adoreblvnk/whattheflip/reports/tribunal-1/SE06_PreTri1.md

# Week 8 Tribunal 1: SE06 Pre-Tribunal Architecture Defence

Group: SE06 (Lab P1) | Repo: https://github.com/adoreblvnk/whattheflip | Target: ESP32-C6 RISC-V @ 160 MHz + Dual RP2040 Picos | OS: uT-Kernel 3.0

## Executive Summary & Document Governance

This document represents Deliverable 1 (`SE06_PreTri1`). We prepared our architecture defence across 3 versions:
* **Version A (Pre-Tribunal AI Ideation):** Fully populated. Contains our pre-tribunal technical preparation across 5 buddies using frontier AI models (Sonnet 5.5, GLM 5.3, and GLM 5.3 Flash). We vetted every recommendation against physical ESP32-C6 hardware constraints and the uT-Kernel 3.0 runtime.
* **Version B (Live Zoom-Updated Version):** Formatted with complete scaffolding. Serves as our live working notebook during the 90-min recorded breakout session (11:15 AM to 12:45 PM), capturing live challenges, counter-defences, and immediate adaptations to the unannounced requirement change.
* **Version C (Final AI-Vetted Gap Check):** Formatted with scaffolding and reflection prompts, scheduled for post-tribunal execution and submission by Oct 23, 23:59 hrs.

## 1. Team Information & Subsystem Ownership

| Item | Details |
|---|---|
| **Group ID** | **SE06 (Lab P1)** |
| **Repository Link** | `https://github.com/adoreblvnk/whattheflip` (Target: ESP32-C6 RISC-V @ 160 MHz, uT-Kernel 3.0) |

### 1.1 Buddy Roster & Technical Responsibilities

| Buddy | Student Name & ID | Primary Subsystem / Persona & Technical Responsibility |
|---|---|---|
| **Buddy 1** | **Tan Yan Qi**<br>*Student Entry* | **Wired Protocol Auto-Discovery Engine:** 4-pin hardware edge timing via RMT RX, pulse histogram profiling, baud estimation (9600 to 115200 baud +- 2%, I2C 100/400 kHz +- 2%), and dynamic probe-to-protocol pin mapping (GP4-GP7). |
| **Buddy 2** | **Annie Goh**<br>*Student Entry* | **Physical Chaos & Fault Injection Engine:** Hardware Event Task Matrix (ETM) / RMT TX pulse glitching (< 500ns jitter), single-bit in-flight flips, I2C ACK to NACK suppression, and 220 ohm series protection clamping. |
| **Buddy 3** | **Zayne Lee**<br>*Student Entry* | **Wireless Multi-Protocol Sniffer:** Promiscuous 2.4 GHz raw radio capture (Wi-Fi 6 / 802.11ax Ch 1-13 management/beacon frames and IEEE 802.15.4 Zigbee Ch 11-26), isolated deauthentication containment. |
| **Buddy 4** | **Ryan Ke**<br>*Student Entry* | **Telemetry Ingestion & PCAP Storage Engine:** Zero-copy fixed memory pool (`MPF_PACKETS`, 32 KB), standard `libpcap` binary packet serialization, FAT32 MicroSD SPI block logging, and Wireshark export. |
| **Buddy 5** | **Joseph Poon**<br>*Student Entry* | **System Supervisor, Safety Lockout & Web UI:** uT-Kernel 3.0 task coordination, hardware GPIO E-Stop direct register override (<= 200ns to High-Z), local Wi-Fi SoftAP WebSocket telemetry server (Ch 6). |

### 1.2 3-Node File Hierarchy & Low-Level Design (LLD) Function Map

We structured our codebase across 3 dedicated hardware nodes following Barr C standard:

```
whattheflip/
├── node1_esp32c6_tool/                # Node 1: Diagnostic Tool & Fuzzer (uT-Kernel 3.0)
│   ├── include/
│   │   ├── auto_discovery.h           # RMT RX edge sampling & baud clustering prototypes
│   │   ├── chaos_fuzzer.h             # ETM / RMT TX glitch injection prototypes
│   │   ├── wireless_sniffer.h         # Wi-Fi 6 & 802.15.4 promiscuous capture prototypes
│   │   ├── pcap_storage.h             # libpcap formatting & SD sector flush prototypes
│   │   ├── supervisor_safety.h        # E-Stop ISR & WebSocket telemetry prototypes
│   │   └── system_config.h            # Pinout definitions (GP4-GP7), pool sizes, baud bounds
│   └── src/
│       ├── auto_discovery.c           # probe_sample_edges_rmt(), classify_baud_histogram()
│       ├── chaos_fuzzer.c             # fuzzer_arm_trigger(), fuzzer_inject_glitch_etm()
│       ├── wireless_sniffer.c         # wifi_promiscuous_rx_cb(), zigbee_frame_parse()
│       ├── pcap_storage.c             # pcap_write_global_hdr(), pcap_write_frame(), sd_flush_sector()
│       ├── supervisor_safety.c        # safety_estop_isr(), ws_broadcast_telemetry()
│       └── main.c                     # inittask(), task creation (tk_cre_tsk), pool init (tk_cre_mpf)
├── node2_pico_wired_victims/          # Node 2: Dual RP2040 Breadboard Testbed (Pico C SDK)
│   ├── victim_a_master/
│   │   ├── main.c                     # pico_a_uart_tx_burst(), pico_a_i2c_master_poll()
│   │   └── gy511_driver.c             # lsm303dlhc_read_accel(), lsm303dlhc_read_mag()
│   └── victim_b_slave/
│       └── main.c                     # pico_b_uart_rx_verify(), pico_b_i2c_slave_handler()
└── node3_esp32c6_wireless_victim/     # Node 3: Wireless Over-the-Air Target (ESP-IDF)
    └── main/
        ├── victim_ap.c                # start_victim_softap(), broadcast_target_beacon()
        └── victim_zigbee.c            # start_802154_tx(), send_raw_zigbee_frame()
```

| Hardware Node & File | LLD Function Name | Owner & RTOS Task | Purpose & Execution Context |
|---|---|---|---|
| **Node 1 (ESP32-C6)**<br>`src/auto_discovery.c` | `probe_sample_edges_rmt()` | **Tan**<br>`AutoDiscovery_Task` (P4) | Streams pulse duration items via RMT RX DMA into internal ring buffers; 0 CPU interrupt overhead. |
| **Node 1 (ESP32-C6)**<br>`src/auto_discovery.c` | `classify_baud_histogram()` | **Tan**<br>`AutoDiscovery_Task` (P4) | Runs statistical clustering on edge times; locks protocol within <= 500ms; emits `FLG_PROTO_LOCKED`. |
| **Node 1 (ESP32-C6)**<br>`src/chaos_fuzzer.c` | `fuzzer_arm_trigger()` | **Annie**<br>`Chaos_Fuzzer_Task` (P3) | Acquires `MTX_PROBE_ACCESS`, arms hardware ETM comparator, and configures pulse width (<= 10us). |
| **Node 1 (ESP32-C6)**<br>`src/chaos_fuzzer.c` | `fuzzer_inject_glitch_etm()` | **Annie**<br>Hardware ETM / RMT TX | Hardware-timed bit-flip or I2C ACK suppression; delivers pulse with < 500ns jitter through 220 ohm resistor. |
| **Node 1 (ESP32-C6)**<br>`src/wireless_sniffer.c`| `wifi_promiscuous_rx_cb()` | **Zayne**<br>Radio Baseband ISR | Executes in < 5us; acquires buffer from `MPF_PACKETS` via `tk_tget_mpf(..., TMO_POL)`; drops frame if full. |
| **Node 1 (ESP32-C6)**<br>`src/wireless_sniffer.c`| `zigbee_frame_parse()` | **Zayne**<br>`Wireless_Engine_Task` (P2) | Drains raw IEEE 802.15.4 frame queue, validates FCS checksum, and pushes to storage buffer. |
| **Node 1 (ESP32-C6)**<br>`src/pcap_storage.c` | `pcap_write_frame()` | **Ryan**<br>`Storage_Task` (P5) | Serializes packets into binary `libpcap` format (16-byte header + payload) and releases pool buffer via `tk_rel_mpf`. |
| **Node 1 (ESP32-C6)**<br>`src/pcap_storage.c` | `sd_flush_sector()` | **Ryan**<br>`Storage_Task` (P5) | Flushes 512-byte aligned sectors to MicroSD SPI card; decoupled via `MBF_STORAGE` (depth 16). |
| **Node 1 (ESP32-C6)**<br>`src/supervisor_safety.c`| `safety_estop_isr()` | **Joseph**<br>GPIO9 Hardware ISR | Direct register write to `GPIO.enable_w1tc` in < 200ns to float probes to High-Z; sets `FLG_SAFETY_ABORT`. |
| **Node 1 (ESP32-C6)**<br>`src/supervisor_safety.c`| `ws_broadcast_telemetry()` | **Joseph**<br>`Web_Dashboard_Task` (P6) | Packages bus statistics into JSON and transmits 1 to 2 Hz WebSocket frames over local Wi-Fi SoftAP (Ch 6). |
| **Node 2 (Pico A)**<br>`victim_a/main.c` | `pico_a_uart_tx_burst()` | Target Breadboard Victim A | Transmits known periodic UART frames (115200 baud) to Victim B for sniffing and fuzzing stimulus. |
| **Node 2 (Pico B)**<br>`victim_b/main.c` | `pico_b_uart_rx_verify()` | Target Breadboard Victim B | Receives UART stream, logs framing error counts and CRC mismatches to USB CDC serial console. |

## 2. Version A: Pre-Tribunal AI Ideation

* **AI Model Evaluation Mandate:** We queried 3 frontier models (Sonnet 5.5, GLM 5.3, and GLM 5.3 Flash) to stress-test subsystem designs against physical ESP32-C6 hardware limits.
* **Evaluation Standard:** We filtered AI suggestions through strict criteria: 0 dynamic heap allocation (`malloc`/`free`), interrupt overhead, sub-microsecond timing accuracy, bus contention, and pin strapping stability.

### 2.1 Pre-Tribunal AI Ideation Matrix

| Subsystem Lead  | AI Model & Prompt Used | Useful AI Ideas | Weak / Unrealistic AI Ideas | Position Before Zoom |
| --- | --- | --- | --- | --- |
| **Tan Yan Qi**  | **Model:** Sonnet 5.5<br><br>**Prompt:** *"I am designing the Wired Protocol Auto-Discovery Engine on ESP32-C6 under uT-Kernel 3.0 across 4 GPIO probe pins (GP4-GP7). We need to identify UART (9600-115200 baud) and I2C (100/400 kHz) within 500 ms without manual probing. What RTOS architecture and hardware peripheral strategy should I use?"* | * Suggested using hardware edge timing (ESP32-C6 RMT RX peripheral) with DMA ring buffers to offload edge capture from CPU.<br>* Proposed statistical pulse width histogramming to cluster baud rates deterministically.<br>* Emphasized keeping probe pins in High-Z floating mode during boot. | * Suggested attaching a software GPIO interrupt ISR (`gpio_isr_handler_add`) to every pin edge and enqueueing timestamps into a message queue (`tk_snd_mbx`).<br>* At 400 kHz I2C, 800,000 edge interrupts/sec would completely overwhelm the 160 MHz RISC-V CPU, causing 100% CPU lockup.<br>* Hallucinated a non-existent ESP32-C6 hardware I2C auto-baud register. | **Reject software GPIO edge ISRs. Commit to hardware RMT RX peripheral offload.** RMT RX captures pulse durations directly into internal RAM without CPU involvement; `AutoDiscovery_Task` (Priority 4) periodically polls and classifies pulse distributions using statistical bounds (eg 8.68us +- 2% for 115200 baud; 2.5us +- 2% for 400 kHz I2C). |
| **Annie Goh** | **Model:** GLM 5.3<br><br>**Prompt:** *"How can I implement deterministic physical bit-flip fault injection and I2C ACK suppression on an ESP32-C6 running uT-Kernel 3.0 with sub-500 ns jitter, while ensuring that driving the target line low does not burn the target microcontrollers (Raspberry Pi Pico)?"* | * Highlighted that RTOS task scheduling jitter (1 to 5us) makes software-timed GPIO toggles unusable for single-bit glitching at 115200 baud (8.68us bit width).<br>* Recommended hardware Event Task Matrix (ETM) tied to RMT/timers for sub-microsecond pulse delivery.<br>* Emphasized open-drain emulation for I2C and hardware clamping. | * Suggested using a bidirectional level shifter (TXS0108E) as an active glitch injector, which introduces 10 to 15ns edge distortion and fails on fast open-drain rise times.<br>* Suggested driving push-pull high directly against victim UART TX, which creates a dead short (> 40mA) and risks silicon degradation. | **Eliminate external level shifter; use direct 3.3V bus coupling with a mandatory 220 ohm inline series resistor on breadboard row GP0 (Victim A TX).** For I2C, strictly enforce open-drain mode (`GPIO_MODE_OUTPUT_OD`) so our tool only pulls LOW and floats HIGH. Pre-acquire `MTX_PROBE_ACCESS` in `Chaos_Fuzzer_Task` (Priority 3) before arming, and trigger pulses via hardware ETM / RMT TX (< 500ns jitter, pulse <= 10us, duty cycle <= 5%). |
| **Zayne Lee** | **Model:** Sonnet 5.5<br><br>**Prompt:** *"On an ESP32-C6 with uT-Kernel 3.0, we need to capture 802.11ax Wi-Fi management frames and IEEE 802.15.4 Zigbee frames simultaneously while hosting a local Web UI for telemetry. What are the RF architecture risks and how should we configure the promiscuous callback?"* | * Confirmed that ESP32-C6 shares a single 2.4 GHz RF front-end between Wi-Fi and 802.15.4, meaning true simultaneous physical capture is impossible.<br>* Recommended a deterministic time-multiplexed capture window.<br>* Warned against executing blocking calls inside the promiscuous callback. | * Claimed ESP32-C6 can do simultaneous full-duplex dual-protocol capture using internal virtual MACs.<br>* Suggested using standard FreeRTOS queues directly inside the ESP-IDF promiscuous callback to pass packets to uT-Kernel, which causes kernel context corruption because ESP-IDF Wi-Fi callbacks run in private ISR context.<br>* Suggested capturing raw BLE link-layer packets without hardware baseband support. | **Formalize RF time-multiplexing: run SoftAP Web UI on Channel 6, and time-slice sniffing windows onto target channels (Wi-Fi Ch 1-13 or 802.15.4 Ch 11-26).** Restrict promiscuous callback to non-blocking memory pool acquisition (`tk_tget_mpf` with `TMO_POL`) from `MPF_PACKETS`; if pool is full, increment drop counter and drop packet immediately rather than stalling radio ISR. Confine deauth frames strictly to Node 3 isolated BSSID (`02:00:00:00:00:03`). |
| **Ryan Ke** | **Model:** GLM 5.3 Flash<br><br>**Prompt:** *"Design a zero-copy telemetry ingestion and MicroSD logging pipeline on ESP32-C6 under uT-Kernel 3.0. The system must buffer wireless bursts and continuous 500 kbps wired streams without dynamic malloc, writing standard libpcap format to a FAT32 MicroSD card. Calculate buffer sizes and determine task priority."* | * Derived that raw 802.11 MTU frames are up to 1514+ bytes (with headers up to 2048 bytes), requiring buffer blocks larger than generic 256-byte sensor buffers.<br>* Recommended pre-allocated Fixed Memory Pools (`tk_cre_mpf`) and 512-byte aligned writes to optimize SPI SD sector flushing. | * Recommended an 8 KB buffer pool with 256-byte blocks, which would instantly truncate or corrupt 802.11 management beacons and Wi-Fi packets.<br>* Suggested writing each packet to MicroSD as JSON text (`fprintf`), which would add severe string formatting overhead and block the SPI bus for > 50ms per write, causing catastrophic packet loss. | **Upsize `MPF_PACKETS` to 32 KB (16 fixed blocks of 2048 B), guaranteeing 0 packet truncation for standard MTU frames.** Serialize packets into binary `libpcap` format (24-byte global header, 16-byte packet header + payload) to enable native Wireshark inspection. Set `Storage_Task` (`TSK_STORAGE`) priority to Low (Priority 5) and decouple it via message queue `MBF_STORAGE` (depth 16) so slow MicroSD SPI sector write latencies (<= 40ms) never stall bus acquisition. |
| **Joseph Poon** | **Model:** GLM 5.3<br><br>**Prompt:** *"How should the System Supervisor task on ESP32-C6 coordinate emergency stop (E-Stop), a local Wi-Fi WebSocket dashboard, and peripheral status indicators under uT-Kernel 3.0, ensuring NFR-1 (E-Stop response <= 5 ms) and zero dynamic memory allocation?"* | * Recommended handling E-Stop as an edge-triggered hardware GPIO interrupt directly manipulating GPIO output-enable registers (`GPIO.enable_w1tc`) to float probe pins in < 200ns, completely bypassing RTOS scheduling latency.<br>* Recommended static buffer allocation for WebSocket frame encoder. | * Suggested including an onboard 0.96 OLED display alongside the WebSocket dashboard. An OLED consumes 1 KB RAM, bus bandwidth, and introduces display-refresh blocking delays (> 20ms) that interfere with supervisor responsiveness.<br>* Suggested routing E-Stop through a normal RTOS message queue to be processed by a worker task, violating the <= 5ms safety preemption requirement. | **Drop the OLED display; rely entirely on the WebSocket dashboard over Wi-Fi and onboard NeoPixel/buzzer.** Implement E-Stop as a 2-stage mechanism: Stage 1 (Hardware ISR) directly clears `GPIO.enable_w1tc` in < 200ns to float all 4 probe channels to High-Z, then sets event flag `FLG_SAFETY_ABORT`; Stage 2 (`Safety_Supervisor_Task`, Priority 1) wakes, commands WS2812 status LED to RED, activates buzzer (`EXIO3`), and coordinates systematic task disarm within 2ms (<= 5ms bound). Ensure GPIO9 boot strapping pin is unpressed during power-up. |

### 2.2 Week 6 Architecture Defence Snapshot Before Zoom

| Week 6 Artefact / Claim | What We Claimed in Week 6 | Evidence Available Now Defending It | Still Weak or Untested | Defending Lead |
|---|---|---|---|---|
| **Hardware Integration:**<br>Direct 3.3V Bus Coupling<br>(NFR-4) | We eliminated TXS0108E bidirectional level shifter; coupled ESP32-C6 probes directly to RP2040 3.3V rails (3.3V +- 5%, V_abs <= 3.63V) with 220 ohm series resistor on Victim A TX line. | Voltage compliance verified against RP2040 datasheet (V_IO = 3.3V) and ESP32-C6 TRM; removing shifter eliminates 10ns propagation delay and open-drain rise-time distortion. 220 ohm resistor bounds push-pull short circuit current to <= 15mA. | Transient capacitive ringing during high-speed switching (> 1 MHz) across breadboard jumper wires not yet verified on high-bandwidth oscilloscope. | **Annie Goh** |
| **Memory Management:**<br>Deterministic Fixed Pool<br>(NFR-2 / NFR-3) | 0 dynamic heap allocations (`malloc`/`free`) during continuous capture and fault injection; all telemetry and packet serialization uses pre-allocated 32 KB Fixed Memory Pool `MPF_PACKETS` (16 blocks of 2048 B). | Week 6 memory map allocates `MPF_PACKETS` in BSS segment; diagnostic benchmark (`test1_chip_diagnostics.ino`) confirms 512 KB SRAM headroom with > 250 KB free heap remaining. | Sustained 10-min continuous stress test at 500 kbps to verify 0 pool exhaustion when MicroSD sector write latency spikes to 40ms. | **Ryan Ke** |
| **Fault Injection Precision:**<br>Sub-Microsecond Glitch Timing<br>(NFR-5) | Fault injection pulses synchronize to target bus trigger edges with timing jitter < 500ns, completely bypassing RTOS task scheduling jitter. | Hardware Event Task Matrix (ETM) connects GPIO comparator directly to RMT TX channel; hardware trigger path operates within 3 to 5 clock cycles (< 50ns at 160 MHz). | Jitter under heavy radio DMA traffic (concurrent Wi-Fi promiscuous RX) not yet empirically measured on physical digital storage oscilloscope. | **Annie Goh** |
| **Safety Architecture:**<br>E-Stop Hardware Preemption <= 5ms<br>(NFR-1) | Emergency stop on GP12 (`GPIO9` BOOT switch) preempts all background processing, floating all 4 probe channels to High-Z within < 200ns (ISR) and completing system-wide alarm and task disarm within <= 5ms. | Stage 1 ISR directly writes to 32-bit register `GPIO.enable_w1tc`, taking < 50ns; `Safety_Supervisor_Task` runs at highest system priority (Priority 1). | Verifying that pressing E-Stop during power-on reset does not hold GPIO9 low and accidentally force ESP32-C6 into ROM UART bootloader mode. | **Joseph Poon** |
| **Bus Auto-Discovery:**<br>Hardware RMT RX Offload<br>(FR-1 / FR-2) | Passive auto-discovery accurately identifies UART (9600-115200 baud, +- 2%) and I2C (100/400 kHz, +- 2%) within <= 500ms across 4 pins without CPU interrupt thrashing. | ESP32-C6 RMT peripheral has 4 RX channels capable of streaming pulse duration items directly to RAM via DMA without per-edge CPU interrupts. | Accuracy of statistical baud clustering in the presence of bus noise, reflections, or flat-line idle states during bus reset. | **Tan Yan Qi** |
| **Wireless Architecture:**<br>Time-Multiplexed 2.4 GHz RF Front-End<br>(FR-4 / Assumption A4) | The single 2.4 GHz RF transceiver operates in distinct, time-multiplexed capture modes (Wi-Fi 6 promiscuous Ch 1-13 vs IEEE 802.15.4 Zigbee Ch 11-26), while the Web UI dashboard runs on Home Channel 6. | ESP32-C6 RF architecture documentation confirms shared baseband; firmware state machine implements dedicated `WIFI_SNIFF` and `ZIGBEE_SNIFF` states. | Packet loss rate of WebSocket telemetry updates during channel-hopping sweeps across distant Wi-Fi channels (eg Ch 1 or Ch 13). | **Zayne Lee** |

### 2.3 Shared Resource Allocation Matrix

| Shared Resource | Used by Task(s) | Owner Task / Module | Access Type | Contention Risk | Mitigation | Evidence Needed |
| --- | --- | --- | --- | --- | --- | --- |
| **Probe GPIO Bus**<br>(GP4-GP7 / GPIO6, 7, 14, 15) | `AutoDiscovery_Task`, `Chaos_Fuzzer_Task`, `Safety_Supervisor_Task` | `AutoDiscovery_Task` (Default), `Chaos_Fuzzer_Task` (Armed) | Time-exclusive; High-Z read default; Transient low drive during glitch  | Fuzzer drives pin while Auto-Discovery is measuring edge timing, corrupting baud estimation or creating bus contention. | Protected by uT-Kernel mutex `MTX_PROBE_ACCESS`. Fuzzer must acquire mutex before arming. E-Stop ISR overrides via direct register write. | DSO capture showing probe pins cleanly release to High-Z before fuzzer arming; 0 mutex deadlocks over 100 contention cycles. |
| **Onboard MicroSD Card SPI Bus**<br>(GPIO10, 11, 12, 15 / Pins 14-16, 20) | `Storage_Task` exclusively; inputs fed from `Wireless_Engine` & `AutoDiscovery` | `Storage_Task` (`TSK_STORAGE`) | Dedicated master SPI bus; block sector writes (512 B) | Slow SD card flash write latency spikes (<= 40ms) block high-speed packet ingestion tasks. | Decoupled by message buffer `MBF_STORAGE` (depth 16) and zero-copy fixed memory pool `MPF_PACKETS`. Producer tasks enqueue pointers; `Storage_Task` drains at Priority 5. | Benchmark showing 0 dropped packets during simulated 40ms SD card flash block-erase stall. |
| **2.4 GHz RF Transceiver Baseband** | `Wireless_Engine_Task`, `Web_Dashboard_Task` | `Wireless_Engine_Task` (`TSK_WIRELESS`) | Time-multiplexed RF front-end (RX promiscuous vs TX SoftAP beacon/data) | SoftAP telemetry broadcasts on Channel 6 interrupted or dropped when radio hops to Channel 1 or Zigbee Channel 15 to capture packets. | Time-sliced buffering: sniffer captures on target channel for 1 to 2s into memory pool, then returns to Channel 6 to flush telemetry over WebSocket. | RF channel dwell timer logs showing clean return to Channel 6 without WebSocket client disconnection. |
| **Fixed Packet Memory Pool**<br>(`MPF_PACKETS`, 32 KB / 16 Blocks of 2048 B) | `Wireless_Engine_Task`, `AutoDiscovery_Task`, `Storage_Task`, `Web_Dashboard` | Kernel Object (`MPF_PACKETS`), allocated at system boot | Zero-copy pointer exchange across task message queues | Memory pool exhaustion during burst traffic leads to task deadlock or packet dropping. | Non-blocking acquisition `tk_tget_mpf(..., TMO_POL)`. If pool exhausted, drop packet and increment drop counter; never block radio ISR. Consumers release via `tk_rel_mpf`. | Stress test verifying pool block count never leaks over 10,000 allocate/release cycles. |
| **Onboard I2C Expansion Bus**<br>(TCA9554PWR on GPIO22/GPIO23) | `Safety_Supervisor_Task` exclusively | `Safety_Supervisor_Task` (`TSK_SAFETY`) | Master I2C write to control Piezo Buzzer (`EXIO3`) and status LEDs | I2C bus hang or arbitration loss if another task attempts to probe expander pins while safety buzzer is being commanded. | Strictly isolate TCA9554PWR I2C bus to `Safety_Supervisor_Task`. Baseboard pushbuttons 1 & 2 (GP20/GP21) are strictly banned from software use to prevent shorting expander I2C lines to ground. | I2C bus analyzer log confirming 0 unauthorized transactions on address `0x20` (TCA9554). |

### 2.4 Subsystem Interface and Code Structure Map

| Module / File / Interface | Provider | Consumer(s) | Purpose | Inputs | Outputs | Interface Rule | Validation Rule |
| --- | --- | --- | --- | --- | --- | --- | --- |
| `auto_discovery.c`<br>`probe_sample_edges_rmt()` | **Tan** | `AutoDiscovery_Task`, `Chaos_Fuzzer_Task`, `Web_Dashboard_Task` | Samples edge transition timestamps from 4 probe channels via RMT RX, computes pulse statistics, and resolves active bus pinout. | RMT RX DMA raw buffer (pulse item stream, microsecond timestamps) | `proto_desc_t` (Protocol: UART/I2C/IDLE, Baud rate, Pin roles: TX, RX, SDA, SCL) | Only `AutoDiscovery_Task` executes baud classification; emits event flag `FLG_PROTO_LOCKED` upon stable identification (>= 95% confidence over 500ms). | Pass if UART (9600-115200 baud, +- 2%) and I2C (100/400 kHz, +- 2%) correctly identified within <= 500ms on test bench. |
| `chaos_fuzzer.c`<br>`fuzzer_invert_uart_bit()`<br>`fuzzer_ack_suppress_i2c()` | **Annie** | `Chaos_Fuzzer_Task`, Target Victims (Pico A & Pico B) | Injects deterministic, single-bit pulse glitches (< 500ns jitter) or pulls I2C SDA low during 9th clock cycle to force NACK. | Fuzz target trigger pattern, delay offset, pulse duration (<= 10us, duty cycle <= 5%) | Timed GPIO pulse on probe line via hardware ETM / RMT TX channel | Must acquire `MTX_PROBE_ACCESS` before configuring ETM trigger; immediately float pin to High-Z upon completion or E-Stop event flag. | Oscilloscope capture showing edge-to-pulse jitter < 500ns, current draw <= 15mA through 220 ohm resistor, and victim reporting framing error/NACK. |
| `wireless_sniffer.c`<br>`wifi_promiscuous_rx_cb()`<br>`zigbee_rx_cb()` | **Zayne** | `Wireless_Engine_Task`, `Storage_Task`, `Web_Dashboard_Task` | Captures raw over-the-air 802.11ax and 802.15.4 packets, filters headers, extracts RSSI, and passes packets to storage buffer. | Raw radio baseband FIFO interrupts and frame buffers | Serialized packet buffer pushed to `MBF_STORAGE` and `MBF_TELEMETRY` | Promiscuous callback must execute in < 5us; acquires buffer via `tk_tget_mpf(..., TMO_POL)`; drops frame if pool is full; never blocks. | Serial log confirming <= 0.1% frame drop rate during 100 pkt/s beacon burst; Wireshark validates captured PCAP checksums. |
| `pcap_storage.c`<br>`pcap_write_frame()`<br>`sd_flush_sector()` | **Ryan** | `Storage_Task`, MicroSD SPI Driver | Formats captured packets with 16-byte `libpcap` header, stages data into 512-byte sector cache, and flushes to FAT32 MicroSD card. | Packet descriptor from `MBF_STORAGE`, microsecond timestamp, length, raw bytes | 512-byte block SPI commands to MicroSD card (`/sdcard/capture.pcap`) | All writes are sector-aligned; 0 dynamic allocations; releases packet buffer back to `MPF_PACKETS` via `tk_rel_mpf` immediately after sector staging. | MicroSD card mounted on PC opens in Wireshark with 0 corrupted headers or malformed length fields. |
| `supervisor_safety.c`<br>`safety_estop_isr()`<br>`ws_broadcast_telemetry()` | **Joseph** | `Safety_Supervisor_Task`, All system tasks, Web UI clients | Coordinates system health monitoring, executes hardware E-Stop probe disarm, and streams live 1 to 2 Hz JSON telemetry over WebSocket. | GPIO9 switch interrupt, system task health flags, telemetry queue `MBF_TELEMETRY` | `GPIO.enable_w1tc` 32-bit register clear, WS2812 LED color, buzzer output, WebSocket JSON frames over Wi-Fi | Stage 1 E-Stop executes directly in ISR without RTOS scheduling; WebSocket transmission drops telemetry frames if client socket buffer is congested. | Oscilloscope confirms probe pin floats to High-Z within < 200ns of E-Stop press; dashboard displays live packet rate at 1 to 2 Hz +- 10%. |

### 2.5 Week 6 Assumption Closure

| Assumption ID | Original Assumption Statement | Current Status | Evidence Collected | Remaining Risk | Next Action & Owner |
| --- | --- | --- | --- | --- | --- |
| **A0**<br>(Vendor Coexistence) | uT-Kernel 3.0 and ESP-IDF closed-source binary drivers (Wi-Fi/802.15.4 blobs) can coexist via the FreeRTOS translation shim without memory corruption. | **Needs Validation**<br>*(Hurdle for Week 8)* | FreeRTOS translation shim in `esp32c6-mtk3` compiles; standalone benchmark test (`test1_chip_diagnostics.ino`) validates basic RTOS boot. | Vendor Wi-Fi blob may invoke un-shimmed FreeRTOS primitives at runtime, causing silent memory corruption or kernel panic. | Flash test firmware with promiscuous RX enabled; verify 30-min run without panic before Week 8 demo.<br>**Owner:** Zayne |
| **A1**<br>(Direct 3.3V Driving) | ESP32-C6 GPIO pins can switch from High-Z Input to Driven Output in < 1us for targeted bit glitching without damaging target microcontrollers. | **Validated / Closed** | Integrated 220 ohm series resistor limits short-circuit current to <= 15mA; pulse duration clamped to <= 10us (<= 5% duty cycle); open-drain mode used on I2C. | Minor capacitive rise time degradation on breadboard wiring (~15ns). | Probe edge slew rate on physical DSO during Week 8 lab session.<br>**Owner:** Annie |
| **A2**<br>(Buffer Overrun Risk) | ESP32-C6 promiscuous packet filter captures raw 802.11 management frames without dropping frames at burst rates up to 50 to 100 pkts/s. | **Validated / Closed** | Fixed memory pool `MPF_PACKETS` upsized from 8 KB to 32 KB (16 blocks of 2048 B), absorbing burst traffic even when MicroSD write stalls for 40ms. | Flash write latency exceeding 100ms on degraded/unbranded SD cards. | Mandate SanDisk Extreme Class 10 U3 MicroSD card; measure sector write latency distribution.<br>**Owner:** Ryan |
| **A3**<br>(Deauth Containment) | Targeted deauth injection will be contained strictly to isolated testbed victim node without spilling into campus Wi-Fi. | **Validated / Closed** | Hardware BSSID/MAC allow-list (`02:00:00:00:00:03`) hardcoded in firmware; broadcast deauth (`FF:FF:FF:FF:FF:FF`) strictly prohibited in software state machine. | User accidentally modifying target MAC address in web dashboard. | Enforce firmware validation check that rejects any MAC outside the testbed namespace.<br>**Owner:** Zayne |
| **A4**<br>(Single RF Multiplexing) | Single 2.4 GHz RF front-end can switch between Wi-Fi and Zigbee without crashing the SoftAP telemetry server. | **Converted to Risk / Mitigated** | Time-sliced capture architecture documented in Section 2; dashboard operates on Channel 6, sniffer sweeps remote channels and buffers data locally before returning to Channel 6. | WebSocket client may experience momentary 1-second packet delivery latency during channel hop. | Implement client-side WebSocket heartbeat reconnection handling in HTML5 dashboard.<br>**Owner:** Joseph |
| **A5**<br>(Auto-Discovery Accuracy) | Passive 4-pin auto-discovery edge timing can classify UART and I2C within 500ms without false locks. | **Open / In Progress** | RMT RX DMA driver implemented; timing threshold tables defined (8.68us +- 2% for 115200 baud; 2.5us +- 2% for 400 kHz I2C). | High bus noise or floating pins could trigger spurious edge transitions before protocol lock. | Integrate 3-stage debounce filter and require at least 16 valid consecutive edge rhythms before emitting `FLG_PROTO_LOCKED`.<br>**Owner:** Tan |
| **A6**<br>(E-Stop & GPIO9 Invariant) | Hardware E-Stop button on GPIO9 can preempt all tasks within 5ms while maintaining boot stability. | **Validated / Closed** | ISR writes to `GPIO.enable_w1tc` in < 200ns; operational invariant established requiring GPIO9 to remain unpressed during the first 50ms power-on reset. | User accidentally holding E-Stop during board power-up, causing ESP32-C6 to enter ROM download mode. | Add power-on warning LED pattern in bootloader and document requirement in physical testbed setup guide.<br>**Owner:** Joseph |
| **A7**<br>(GPIO15 JTAG Strapping) | PROBE_3 on GPIO15 (Maker Pi GP7) can be used as a probe without interfering with JTAG debug or board reset. | **Validated / Closed** | GPIO15 is kept in High-Z floating mode during boot; verified ESP32-C6 boot log via UART0 console shows normal flash boot into application. | Victim pulling line LOW during reset could divert JTAG lines. | Connect I2C SCL to GP7 only after boot confirmation or use internal pull-up.<br>**Owner:** Tan |

## 3. Version B: Live Zoom-Updated Version (Live Tribunal Session)

> **LIVE SESSION WORKING NOTEBOOK (OCTOBER 19, 11:15 TO 12:45)**  
> This section records our live technical challenges, counter-defences, decision changes, and system adaptations in response to **Change Requirement 3: Port to µT-Kernel 3 SMP** issued by Prof. Muhamed Fauzi Bin Abbas.

### 3.1 Buddy Contributions During Zoom
| Team Member | Technical Challenge Raised | Teammate Counter-Challenge / Defence | Engineering Trade-Off / Compromise Reached | Affected Artefact / File |
|---|---|---|---|---|
| **Tan Yan Qi**<br>(Auto-Discovery) | Evaluated porting Node 1 auto-discovery to µT-Kernel 3 SMP, proposing a secondary core task to process RMT edge buffers, per Sonnet 5.5 output. | Joseph proved the ESP32-C6 is single-core silicon (`PORT_ESP32C6.md` line 128: *"makes no attempt at SMP"*). Ryan added that RMT RX offloads edge timing to DMA at 0% CPU, making multi-core processing redundant. | Retained Node 1 on single-core µT-Kernel 3.0 (`esp32c6-mtk3`). Redirected the µT-Kernel 3 SMP port (`mtk3smp-rp2040`) to Node 2 (Dual RP2040 Victims), assigning Core 0 to UART Master and Core 1 to I2C Master. | `node1_esp32c6_tool/src/auto_discovery.c`<br>`node2_pico_wired_victims/victim_a_master/main.c` |
| **Annie Goh**<br>(Chaos Fuzzer) | Investigated moving hardware fuzzer trigger loops to Core 1 of an SMP processor to execute parallel glitch injection. | Joseph cited `PORT_RP2040.md` showing the recursive Big Kernel Lock (BKL) has a worst-case hold time of 85µs and masks local interrupts, which would introduce tens of microseconds of jitter into glitch pulses. | Kept fuzzer on Node 1 ESP32-C6 where hardware Event Task Matrix (ETM) and RMT TX trigger glitch pulses in < 50ns, completely bypassing RTOS scheduling and SMP lock contention. | `node1_esp32c6_tool/src/chaos_fuzzer.c`<br>`fuzzer_inject_glitch_etm()` |
| **Zayne Lee**<br>(Wireless Sniffer) | Evaluated migrating Node 3 (Wireless Victim) to a Raspberry Pi Pico W running `mtk3smp-rp2040` (`SMP=1 WIFI=cyw43`) to satisfy the SMP requirement on wireless. | Joseph and Annie proved that the Pico W's CYW43439 radio is Wi-Fi 4 (802.11b/g/n) only and has 0% IEEE 802.15.4 silicon, making Zigbee transmission physically impossible; SoftAP beaconing is also unported. | Retained Node 3 on ESP32-C6 under ESP-IDF to preserve native Wi-Fi 6 + 802.15.4 frame generation. Defended this as an unalterable physical radio hardware constraint. | `node3_esp32c6_wireless_victim/main/victim_ap.c`<br>`node3_esp32c6_wireless_victim/main/victim_zigbee.c` |
| **Ryan Ke**<br>(PCAP Storage) | Explored offloading `Storage_Task` to Core 1 under SMP to decouple MicroSD SPI sector writes from packet capture. | Tan noted that `PORT_RP2040.md` lists inherited peripheral drivers as single-owner and includes zero FAT32 / SD card drivers in its qualified release; an SMP SD driver would require writing a custom locking layer. | Retained `Storage_Task` on Node 1 ESP32-C6 at Priority 5, using `SPI2_HOST` with `MBF_STORAGE` (depth 16) and `MPF_PACKETS` (32 KB fixed pool), absorbing 40ms SD write stalls without SMP lock overhead. | `node1_esp32c6_tool/src/pcap_storage.c`<br>`sd_flush_sector()` |
| **Joseph Poon**<br>(Supervisor & Safety) | Audited Change Requirement 3's mandate ("Port to µT-Kernel 3 SMP") and identified a fatal safety conflict: the 85µs BKL interrupt-mask window destroys the < 200ns E-Stop requirement. | Team unanimously agreed: forcing Node 1 to RP2040 SMP degrades safety response by 425x. Furthermore, the RP2040 SMP port provides no qualified SoftAP or WebSocket stack for the telemetry dashboard. | Adopted the definitive architectural cutover: Port Node 2 (Dual RP2040 Victims) to `mtk3smp-rp2040` (`SMP=1`), assigning Core 0 (`TP_PRC1`) to UART and Core 1 (`TP_PRC2`) to I2C via `TA_ASSPRC`. Node 1 and Node 3 remain single-core. | `node1_esp32c6_tool/src/supervisor_safety.c`<br>`node2_pico_wired_victims/app_main.c` |

### 3.2 Live Decision Change Log
| Decision ID | Item / Topic | Decision (Changed vs Kept) | Engineering Reason & Evidence | Owner / Subsystem |
|---|---|---|---|---|
| **D-01** | Node 2 Wired Victims OS Architecture | **CHANGED** | Ported Node 2 Dual RP2040 Victims from bare-metal Pico SDK to µT-Kernel 3 SMP (`mtk3smp-rp2040`, `SMP=1`). Core 0 runs `Victim_A_UART_Task`; Core 1 runs `Victim_B_I2C_Task`. Fulfills CR3 mandate. | Tan / Auto-Discovery |
| **D-02** | Node 2 SMP Task-to-Core Affinity | **CHANGED** | Configured static processor affinity using `TA_ASSPRC`: `Victim_A_Task` assigned to Processor 1 (`TP_PRC1` / Core 0); `Victim_B_Task` assigned to Processor 2 (`TP_PRC2` / Core 1). Synchronized via `MBF_VICTIM_SYNC`. | Annie / Chaos Fuzzer |
| **D-03** | Node 1 Diagnostic Tool OS Architecture | **KEPT (CONFIRMED)** | Retained Node 1 on single-core µT-Kernel 3.0 (`esp32c6-mtk3`). Proved ESP32-C6 silicon is single-core (`PORT_ESP32C6.md` line 128); prevents 85µs BKL interrupt masking from violating the < 200ns E-Stop preemption limit. | Joseph / Safety Supervisor |
| **D-04** | Node 3 Wireless Victim Platform | **KEPT (CONFIRMED)** | Retained Node 3 on ESP32-C6 under ESP-IDF. Raspberry Pi Pico W's CYW43439 lacks IEEE 802.15.4 (Zigbee) radio hardware, lacks Wi-Fi 6, and provides no qualified SoftAP beacon generator in `mtk3smp-rp2040`. | Zayne / Wireless Sniffer |
| **D-05** | Zero Dynamic Heap Invariant | **KEPT (CONFIRMED)** | Rejected AI recommendation for dynamic SMP task queues; retained 32 KB Fixed Memory Pool `MPF_PACKETS` (16 blocks of 2048 B) and statically allocated task stacks across both Node 1 and Node 2. | Ryan / PCAP Storage |
| **D-06** | Hardware E-Stop Direct Register Override | **KEPT (CONFIRMED)** | Stage 1 ISR direct write to `GPIO.enable_w1tc` in < 200ns on GPIO9 BOOT switch retained without kernel lock interference. Stage 2 supervisor task preemption completes in <= 5ms. | Joseph / Safety Supervisor |

### 3.3 Resource and Assumption Review
| Item Challenged | Evidence Presented | Decision Made | Impact on Other Buddies |
|---|---|---|---|
| **Silicon Core Architecture (ESP32-C6 vs RP2040)** | `PORT_ESP32C6.md` line 128 states C6 port is single-core only. `PORT_RP2040.md` lines 3-6 confirms RP2040 is the ONLY SMP port in the course family. | Prohibit running SMP on Node 1 (ESP32-C6). Target the µT-Kernel 3 SMP port strictly to Node 2 (RP2040). | All buddies keep their Node 1 firmware structure; Tan and Annie write SMP tasks for Node 2. |
| **Big Kernel Lock (BKL) Interrupt Masking** | `PORT_RP2040.md` records 85µs maximum BKL hold time and notes *"BKL masks local interrupts while held."* | Keep E-Stop ISR decoupled from BKL; Stage 1 register write must never wait on SMP spinlocks. | Joseph guarantees < 200ns probe isolation; fuzzer disarm remains 100% deterministic. |
| **2.4 GHz RF Front-End Capabilities** | Pico W CYW43439 datasheet: Wi-Fi 4 only, 0% 802.15.4 silicon. `PORT_RP2040.md`: CYW43439 is a development profile without SoftAP. | Reject migrating Node 3 to Pico W. Keep Node 3 on ESP32-C6 to generate real 802.11ax and 802.15.4 frames. | Zayne captures valid multi-protocol wireless frames; Joseph's dashboard remains on Home Ch 6. |
| **RP2040 I2C Peripheral Driver Scope** | `mtk3smp-rp2040/device/i2c/sysdepend/rp2040/i2c_rp2040.c` hardcodes `I2C_CON_SLAVE_DISABLE | I2C_CON_MASTER_MODE`. | On Node 2, configure Core 1 Victim B as an I2C Master reading a second sensor, or patch driver for slave mode. | Eliminates driver lockup on Node 2 breadboard testbed. |
| **32 KB Fixed Memory Pool (`MPF_PACKETS`)** | Memory audit confirms 16 blocks of 2048 B absorb 40ms MicroSD flash write stalls at 500 kbps wired streaming. | Retain 32 KB fixed pool size; zero heap allocation during active monitoring and fault injection. | Ryan guarantees zero buffer overflow; memory pool watermark logged to telemetry. |

### 3.4 Integration Risk Register
| Risk ID | Risk Description | Cause | Impact | Likelihood | Severity | Mitigation | Owner & Status |
|---|---|---|---|---|---|---|---|
| **R1** | BKL contention on Node 2 causes timing jitter in victim UART/I2C stimulus generation. | Both cores on RP2040 serialize through single recursive Big Kernel Lock (85µs hold). | Cross-core message handoff delays and irregular victim transmission intervals. | Med | Med | Decouple victim tasks using lockless circular ring buffers (`smp_atomic.c`) outside the BKL. | Tan / Open |
| **R2** | RP2040 stock I2C driver in `mtk3smp` is master-only, preventing standard I2C slave response. | Driver hardcodes `I2C_CON_SLAVE_DISABLE`; slave mode unported in official release. | Victim B cannot acknowledge I2C read requests from Victim A. | High | High | Reconfigure Victim B on Core 1 as a second I2C master polling on separate address, or patch `i2c_rp2040.c`. | Annie / Open |
| **R3** | Breadboard signal ringing between dual RP2040 fast GPIO edges and ESP32-C6 probe inputs. | Fast Cortex-M0+ switching slew rates across 15 cm solderless breadboard jumper wires. | False edge triggers or degraded baud rate classification on Auto-Discovery. | Med | Med | Maintain inline 220 ohm series protection resistors and enable RMT RX 3-cycle digital debounce filter. | Tan / Open |

### 3.5 Cross-Subsystem Test Plan
| Test ID | Subsystem / Workload | Test Case Description | Objective Success Criteria | Evidence Required | Owner & Status |
|---|---|---|---|---|---|
| **TC-INT-1** | SMP Multi-Core Task Affinity | Execute `Victim_A_UART_Task` on Core 0 (`TP_PRC1`) and `Victim_B_I2C_Task` on Core 1 (`TP_PRC2`) concurrently. | Processor IDs reported via `tk_get_prc()` strictly match 1 and 2; zero cross-core task migration. | USB-CDC serial console log showing concurrent dual-core execution banner. | Tan / Open |
| **TC-INT-2** | Emergency Stop Preemption under SMP | Trigger E-Stop while Node 2 RP2040 is actively transmitting dual-core UART + I2C burst traffic. | Probe pins float to High-Z in < 200ns; system disarms in <= 5ms; zero bus contention current. | DSO capture showing probe line floating within < 200ns of GPIO9 edge + serial log. | Joseph / Open |
| **TC-INT-3** | Cross-Core IPC & BKL Soak Test | Stream 10,000 cross-core synchronization tokens between Core 0 and Core 1 via `MBF_VICTIM_SYNC`. | 100% token integrity; 0 dropped messages; maximum BKL wait <= 36µs; zero kernel lockups over 10-min soak. | Test log showing 10,000/10,000 matched tokens with zero API errors. | Annie / Open |
| **TC-INT-4** | Multi-Protocol Capture against SMP Testbed | ESP32-C6 captures concurrent Node 2 SMP wired traffic (115200 baud) and Node 3 wireless beacons. | PCAP file written to MicroSD contains valid interleaved UART packets and Wi-Fi beacons; drop rate <= 0.1%. | PCAP file opened in Wireshark with zero corrupted headers or malformed frames. | Ryan / Open |

### 3.6 Constraint Injection / Curveball Response
* **Injected Requirement Change (Verbatim):** *The system firmware must be ported from its current RTOS to µT-Kernel 3 SMP, using the course µT-Kernel 3 SMP port. All existing application functionality must operate under µT-Kernel 3 SMP. The previous RTOS must not remain responsible for any application task, scheduling, inter-task communication or synchronisation. As this is an SMP implementation, teams must define and justify the task-to-core assignment. Data and resources shared between tasks or cores must be protected appropriately, and ISRs must interact safely with µT-Kernel tasks.*

| Team Member | Immediate Impact on Subsystem | Specific Firmware / Hardware Adaptation | Trade-Off / Unaffected Rationale |
|---|---|---|---|
| **Tan Yan Qi** | Evaluated auto-discovery multi-core offload. Found ESP32-C6 is single-core; RP2040 is the only SMP hardware. | Ported Node 2 Wired Victims to `mtk3smp-rp2040` (`SMP=1`); implemented `Victim_A_UART_Task` pinned to Core 0 (`TP_PRC1`). | Auto-discovery on Node 1 remains on single-core µT-Kernel 3.0; hardware RMT RX DMA already achieves 0% CPU. |
| **Annie Goh** | Evaluated moving fuzzer to an SMP core; found 85µs BKL interrupt mask destroys < 500ns glitch jitter. | Implemented `Victim_B_I2C_Task` on Node 2 Core 1 (`TP_PRC2`) via `TA_ASSPRC` to provide dual-core victim stimulus. | Fuzzer on Node 1 remains on single-core ESP32-C6 ETM hardware to guarantee < 50ns trigger jitter. |
| **Zayne Lee** | Investigated migrating Node 3 to Pico W SMP; found CYW43439 lacks 802.15.4 Zigbee radio hardware. | Kept Node 3 on ESP32-C6 under ESP-IDF to preserve native Wi-Fi 6 + Zigbee frame transmission. | Pico W CYW43439 is Wi-Fi 4 only and unported for SoftAP beaconing; keeping C6 is a physical necessity. |
| **Ryan Ke** | Evaluated moving storage to SMP; found RP2040 SMP port lacks qualified FAT32 / SD card drivers. | Retained `Storage_Task` on Node 1 ESP32-C6 at Priority 5, flushed via dedicated `SPI2_HOST` controller. | Storage remains fully decoupled via 32 KB `MPF_PACKETS` pool; avoids writing an unqualified SMP SD driver. |
| **Joseph Poon** | Audited E-Stop and Web UI under SMP; found BKL masks interrupts for 85µs (violating < 200ns E-Stop) and CYW43439 lacks WebSockets. | Preserved Stage 1 direct register write `GPIO.enable_w1tc` (< 200ns) on Node 1. Authored Node 2 dual-core SMP task allocation. | Defended why Node 1 must remain single-core to preserve hard real-time safety and WebSocket telemetry. |

### 3.7 Integration Readiness Self-Assessment
| Readiness Area | Status | Evidence Supporting Assessment | Remaining Concern |
|---|---|---|---|
| **Hardware wiring known** | **Green** | Probe pin mapping frozen on GP4-GP7 (GPIO6, 7, 14, 15); inline 220 ohm protection resistor and unified GND plane verified on breadboard. | Breadboard jumper parasitic capacitance on high-speed switching lines. |
| **RTOS task ownership clear** | **Green** | Node 1: 6 tasks with defined priorities (P1 Safety to P6 Dashboard). Node 2: 2 SMP tasks statically pinned via `TA_ASSPRC` (`TP_PRC1` and `TP_PRC2`). | BKL contention latency on Node 2 cross-core message buffer exchanges. |
| **Shared resources identified** | **Green** | Node 1: `MTX_PROBE_ACCESS` guards probes; `SPI2_HOST` owns MicroSD; `MPF_PACKETS` manages memory. Node 2: RP2040 hardware spinlocks serialize SMP kernel. | Long MicroSD card sector erase latency spikes (> 40ms) under cheap flash media. |
| **Critical statecharts implementable** | **Green** | All 6 subsystem statecharts (System, Auto-Discovery, Fuzzer, Wireless, Storage, Safety) fully integrated with nominal and exception arcs. | Timeout calibration for baud classification rhythm verification under noisy buses. |
| **Safety or fault handling defined** | **Green** | Two-stage E-Stop: Stage 1 hardware ISR (< 200ns) directly writes `GPIO.enable_w1tc`, completely immune to RTOS and BKL scheduling delays; Stage 2 supervisor disarms <= 5ms. | Operational invariant: GPIO9 must remain unpressed during power-on reset. |
| **Week 10 partial integration feasible** | **Green** | Dual-core SMP kernel builds cleanly (`make SMP=1` passes Phase 12 58/58 gate); standalone benchmark validates C6 boot and memory pool allocation. | Soak-testing cross-core token exchange between Victim A and Victim B under continuous fuzzing. |

**Updated readiness position before the Week 10 partial integration demo:**  
Our system architecture has successfully adapted to Change Requirement 3 by deploying the course $\mu\text{T-Kernel}$ 3 SMP port (`mtk3smp-rp2040`, `SMP=1`) on the Node 2 Dual RP2040 Wired Victims. By assigning Core 0 (`TP_PRC1`) to `Victim_A_UART_Task` and Core 1 (`TP_PRC2`) to `Victim_B_I2C_Task` via static affinity (`TA_ASSPRC`), our testbed provides authentic multi-core SMP workload generation with cross-core synchronization while strictly adhering to physical hardware limits. Crucially, Node 1 remains on single-core $\mu\text{T-Kernel}$ 3.0 (`esp32c6-mtk3`), preserving our $< 200\text{ ns}$ direct register E-Stop safety guarantee (`GPIO.enable_w1tc`) free from Big Kernel Lock interrupt masking, and maintaining our dual-protocol 2.4 GHz promiscuous sniffing capabilities. All cross-subsystem contracts remain decoupled through pre-allocated fixed memory pools and message queues, ensuring total integration readiness for Week 10.
## 4. Version C: Final AI-Vetted Gap Check (Scaffolding for Post-Zoom)

> **POST-TRIBUNAL GAP CHECK PROTOCOL (DUE OCTOBER 23, 23:59)**  
> We will execute this section post-Zoom. We will submit the complete Version B discussion transcript and updated decisions to an AI reviewer prompted as a strict embedded systems evaluator. All identified gaps will be logged, triaged (Fix, Reject, Defer), and justified with engineering evidence.

* **AI Reviewer Prompt Used:** *[To be inserted post-Zoom. Format: "Act as a strict embedded systems reviewer for whattheflip. Review the updated Version B decisions, resource allocations, and cross-subsystem test plans..."]*

### 4.1 Post-Discussion AI Gap Analysis
| AI-Identified Gap | Team Response (Fix / Reject / Defer) | Action Taken | Engineering Evidence / Reason |
|---|---|---|---|
| *[Gap 1]* | *[To be filled post-Zoom by Oct 23]* | *[To be filled post-Zoom]* | *[To be filled post-Zoom]* |
| *[Gap 2]* | *[To be filled post-Zoom by Oct 23]* | *[To be filled post-Zoom]* | *[To be filled post-Zoom]* |
| *[Gap 3]* | *[To be filled post-Zoom by Oct 23]* | *[To be filled post-Zoom]* | *[To be filled post-Zoom]* |
| *[Gap 4]* | *[To be filled post-Zoom by Oct 23]* | *[To be filled post-Zoom]* | *[To be filled post-Zoom]* |
| *[Gap 5]* | *[To be filled post-Zoom by Oct 23]* | *[To be filled post-Zoom]* | *[To be filled post-Zoom]* |

### 4.2 Final Tribunal Summary
| Final Reflection Question | Team Answer & Synthesis |
|---|---|
| **What is the strongest part of the current design?** | *[To be synthesized post-Zoom by Oct 23]* |
| **What is most likely to fail?** | *[To be synthesized post-Zoom by Oct 23]* |
| **What evidence supports readiness?** | *[To be synthesized post-Zoom by Oct 23]* |
| **What did AI miss that human discussion revealed?** | *[To be synthesized post-Zoom by Oct 23]* |
| **What did AI correctly identify after discussion?** | *[To be synthesized post-Zoom by Oct 23]* |
