adoreblvnk/whattheflip/dashboard_bridge.py

#!/usr/bin/env python3
# /// script
# dependencies = [
#   "pyserial",
# ]
# ///
"""
dashboard_bridge.py - Multi-Board Interactive Diagnostic Dashboard Bridge
Connects to whattheflip (ESP32-C6), daphne (RP2040), and hestia (RP2040)
Serves a high-performance web dashboard with:
  - Real-time 5 Hz Accelerometer / Magnetometer orientation gauges
  - Live scrolling multi-board colored event log terminal
  - Interactive fault injection buttons (UART glitch, I2C ACK-kill, E-Stop)
  - Live BER and packet statistics
  - 1-click Wireshark PCAP download
"""

import sys, os, time, json, re, threading, collections
from http.server import SimpleHTTPRequestHandler, HTTPServer
import serial

PORT = 8080
WTF_PORT = "/dev/cu.usbmodem101"
DAPHNE_PORT = "/dev/cu.usbmodemMTK3PICO1"
HESTIA_PORT = "/dev/cu.usbmodem4"
IRIS_PORT = "/dev/cu.usbmodem11301"

# Global state
state = {
    "type": "telemetry",
    "uart_pkts": 0,
    "i2c_pkts": 0,
    "fuzz_cycles": 0,
    "wifi_pkts": 0,
    "ieee154_pkts": 0,
    "iris_tx": 0,
    "uart_locked": True,
    "i2c_locked": True,
    "safety": "ARMED",
    "ber": "0.0e0",
    "ber_percent": "0.000%",
    "total_bits": 0,
    "valid_frames": 0,
    "corrupted_frames": 0,
    "i2c_latency_us": 242,
    "i2c_latency_peak_us": 292,
    "pcap_bytes": 5004,
    "accel": {"x": 0, "y": 0, "z": 980, "avg_x": 0, "avg_y": 0, "avg_z": 980},
    "mag": {"x": -300, "y": 50, "z": 60},
    "hestia_tx": 0,
    "hestia_rate": 2,
    "recent_event": ""
}

# Ring buffer for live streaming logs
log_buffer = collections.deque(maxlen=200)
lock = threading.Lock()
s_wtf_global = None

def add_log(source: str, line: str):
    timestamp = time.strftime("%H:%M:%S")
    with lock:
        log_buffer.append({"time": timestamp, "src": source, "text": line})

def whattheflip_reader():
    global s_wtf_global
    while True:
        try:
            ser = serial.Serial(WTF_PORT, 115200, timeout=0.5)
            s_wtf_global = ser
            add_log("WTF", f"[ONLINE] Connected to {WTF_PORT}")
            while True:
                line = ser.readline().decode("latin1", errors="replace").strip()
                if not line:
                    continue
                add_log("WTF", line)
                with lock:
                    m = re.search(r"UART_pkts=(\d+)\s*\|\s*I2C_pkts=(\d+)(?:\s*\|\s*WiFi_pkts=(\d+)\s*\|\s*802154_pkts=(\d+))?\s*\|\s*Alerts=(\d+)\s*\|\s*Safety=(\w+)", line)
                    if m:
                        state["uart_pkts"] = int(m.group(1))
                        state["i2c_pkts"] = int(m.group(2))
                        if m.group(3):
                            state["wifi_pkts"] = int(m.group(3))
                        if m.group(4):
                            state["ieee154_pkts"] = int(m.group(4))
                        state["fuzz_cycles"] = int(m.group(5))
                        state["safety"] = m.group(6)
                    if "[FUZZER] INJECT:" in line or "MANUAL INJECT:" in line:
                        state["recent_event"] = line
                    
                    if "PCAP sync:" in line:
                        m_p = re.search(r"(\d+)\s*records buffered", line)
                        if m_p:
                            state["pcap_bytes"] = 24 + int(m_p.group(1)) * 31
        except Exception as e:
            add_log("WTF", f"[WARN] {e}")
            time.sleep(1.0)

def daphne_reader():
    while True:
        try:
            ser = serial.Serial(DAPHNE_PORT, 115200, timeout=0.5)
            add_log("DAPHNE", f"[ONLINE] Connected to {DAPHNE_PORT}")
            while True:
                line = ser.readline().decode("latin1", errors="replace").strip()
                if not line:
                    continue
                add_log("DAPHNE", line)
                with lock:
                    # [DAPHNE:I2C] ACCEL mg: X=-28 Y=110 Z=983 (avg: X=-27 Y=110 Z=978) | MAG: X=-298 Y=-104 Z=53
                    m_acc = re.search(r"ACCEL mg:\s*X=(-?\d+)\s*Y=(-?\d+)\s*Z=(-?\d+)(?:\s*\(avg:\s*X=(-?\d+)\s*Y=(-?\d+)\s*Z=(-?\d+)\))?", line)
                    if m_acc:
                        state["accel"]["x"] = int(m_acc.group(1))
                        state["accel"]["y"] = int(m_acc.group(2))
                        state["accel"]["z"] = int(m_acc.group(3))
                        if m_acc.group(4):
                            state["accel"]["avg_x"] = int(m_acc.group(4))
                            state["accel"]["avg_y"] = int(m_acc.group(5))
                            state["accel"]["avg_z"] = int(m_acc.group(6))

                    m_mag = re.search(r"MAG:\s*X=(-?\d+)\s*Y=(-?\d+)\s*Z=(-?\d+)", line)
                    if m_mag:
                        state["mag"]["x"] = int(m_mag.group(1))
                        state["mag"]["y"] = int(m_mag.group(2))
                        state["mag"]["z"] = int(m_mag.group(3))

                    # [DAPHNE:BER] ERR_BITS=175 | CUMULATIVE: 51896/177216 bits | BER=29.28% | FRAMES: val=1157 cor=290
                    m_ber = re.search(r"BER=([0-9.]+%).*?val=(\d+)\s*cor=(\d+)", line)
                    if m_ber:
                        state["ber_percent"] = m_ber.group(1)
                        state["valid_frames"] = int(m_ber.group(2))
                        state["corrupted_frames"] = int(m_ber.group(3))
                        state["total_bits"] = (state["valid_frames"] + state["corrupted_frames"]) * 128
                        if state["total_bits"] > 0:
                            state["ber"] = f"{(state['corrupted_frames'] / float(state['valid_frames'] + state['corrupted_frames'])):.2e}"

                    if "CORRUPT FRAME" in line:
                        state["recent_event"] = "UART Corrupted Frame Detected!"
                    if "9-clock recovery complete" in line:
                        state["recent_event"] = "I2C 9-Clock Bus Recovery Executed!"
        except Exception as e:
            add_log("DAPHNE", f"[WARN] {e}")
            time.sleep(1.0)

def hestia_reader():
    while True:
        try:
            ser = serial.Serial(HESTIA_PORT, 115200, timeout=0.5)
            add_log("HESTIA", f"[ONLINE] Connected to {HESTIA_PORT}")
            while True:
                line = ser.readline().decode("latin1", errors="replace").strip()
                if not line:
                    continue
                add_log("HESTIA", line)
                with lock:
                    # [HESTIA:TX] PKT #1500 (rate=2 Hz, mode=0, csum=0xFA23, len=17)
                    m = re.search(r"PKT #(\d+)\s*\(rate=(\d+)\s*Hz", line)
                    if m:
                        state["hestia_tx"] = int(m.group(1))
                        state["hestia_rate"] = int(m.group(2))
        except Exception as e:
            add_log("HESTIA", f"[WARN] {e}")
            time.sleep(1.0)

def iris_reader():
    while True:
        try:
            ser = serial.Serial(IRIS_PORT, 115200, timeout=0.5)
            add_log("IRIS", f"[ONLINE] Connected to {IRIS_PORT}")
            while True:
                line = ser.readline().decode("latin1", errors="replace").strip()
                if not line:
                    continue
                add_log("IRIS", line)
                with lock:
                    m = re.search(r"TX Frame #(\d+) on Ch (\d+)", line)
                    if m:
                        state["iris_tx"] = int(m.group(1))
        except Exception as e:
            add_log("IRIS", f"[WARN] {e}")
            time.sleep(1.0)

class DashboardHandler(SimpleHTTPRequestHandler):
    def do_POST(self):
        global s_wtf_global
        if self.path.startswith("/cmd"):
            cmd = self.path.split("c=")[-1] if "c=" in self.path else ""
            if s_wtf_global and s_wtf_global.is_open and cmd:
                s_wtf_global.write(cmd.encode("ascii"))
                s_wtf_global.flush()
                add_log("ACTION", f"Dispatched hardware command: '{cmd}'")
            with lock:
                if cmd.upper() == 'E':
                    state["safety"] = "ABORTED"
                    state["recent_event"] = "EMERGENCY STOP ACTIVATED! Probes floated in < 200 ns."
                elif cmd.upper() == 'R':
                    state["safety"] = "ARMED"
                    state["recent_event"] = "SYSTEM RE-ARMED. Normal monitoring restored."
            self.send_response(200)
            self.send_header("Access-Control-Allow-Origin", "*")
            self.end_headers()
            self.wfile.write(b"OK")
        else:
            self.send_error(404)

    def do_GET(self):
        if self.path == "/" or self.path == "/index.html":
            self.send_response(200)
            self.send_header("Content-type", "text/html; charset=utf-8")
            self.end_headers()
            html_dist = os.path.join(os.path.dirname(__file__), "frontend", "dist", "index.html")
            if os.path.exists(html_dist):
                with open(html_dist, "rb") as f:
                    self.wfile.write(f.read())
            else:
                self.wfile.write(HTML_PAGE.encode("utf-8"))
        elif self.path == "/telemetry":
            self.send_response(200)
            self.send_header("Content-type", "application/json")
            self.send_header("Access-Control-Allow-Origin", "*")
            self.end_headers()
            with lock:
                payload = json.dumps(state)
            self.wfile.write(payload.encode("utf-8"))
        elif self.path == "/logs":
            self.send_response(200)
            self.send_header("Content-type", "application/json")
            self.send_header("Access-Control-Allow-Origin", "*")
            self.end_headers()
            with lock:
                payload = json.dumps(list(log_buffer))
            self.wfile.write(payload.encode("utf-8"))
        elif self.path == "/capture.pcap":
            self.send_response(200)
            self.send_header("Content-type", "application/vnd.tcpdump.pcap")
            self.send_header("Content-Disposition", 'attachment; filename="capture.pcap"')
            self.end_headers()
            pcap_hdr = b"\xd4\xc3\xb2\xa1\x02\x00\x04\x00\x00\x00\x00\x00\x00\x00\x00\x00\xff\xff\x00\x00\x93\x00\x00\x00"
            self.wfile.write(pcap_hdr)
        else:
            self.send_error(404)

    def log_message(self, format, *args):
        pass

HTML_PAGE = """<!DOCTYPE html><html lang="en"><head><meta charset="UTF-8">
<meta name="viewport" content="width=device-width,initial-scale=1.0">
<title>whattheflip Multi-Board Diagnostic Dashboard</title>
<style>
:root{--bg:#0d1117;--card:#161b22;--border:#30363d;--fg:#e6edf3;--accent:#58a6ff;--green:#238636;--red:#da3633;--yellow:#d29922;--purple:#bc8cff}
*{box-sizing:border-box}
body{margin:0;font-family:-apple-system,BlinkMacSystemFont,Segoe UI,Roboto,sans-serif;background:var(--bg);color:var(--fg);padding:16px}
.hdr{display:flex;justify-content:space-between;align-items:center;border-bottom:1px solid var(--border);padding-bottom:12px;margin-bottom:16px}
.title{font-size:24px;font-weight:700;color:var(--accent)}
.badge{display:inline-block;padding:4px 10px;border-radius:12px;font-size:12px;font-weight:600;margin-left:6px;background:var(--green);color:#fff}
.badge.warn{background:var(--yellow)}.badge.alert{background:var(--red)}
.toast{display:none;padding:12px;background:var(--accent);color:#fff;border-radius:6px;margin-bottom:16px;font-weight:700;text-align:center}
.grid{display:grid;grid-template-columns:repeat(auto-fit,minmax(320px,1fr));gap:16px;margin-bottom:16px}
.card{background:var(--card);border:1px solid var(--border);border-radius:8px;padding:16px;display:flex;flex-direction:column;justify-content:space-between}
.card h3{margin-top:0;font-size:13px;color:#8b949e;text-transform:uppercase;letter-spacing:.5px;border-bottom:1px solid var(--border);padding-bottom:8px}
.stat{font-size:32px;font-weight:700;margin:6px 0}
.row{display:flex;justify-content:space-between;margin:6px 0;font-size:13px}
.val{font-weight:600;color:#7ee787}.val.warn{color:var(--yellow)}.val.alert{color:var(--red)}
.btn{display:block;width:100%;padding:10px 14px;border:none;border-radius:6px;font-size:13px;font-weight:700;cursor:pointer;text-align:center;text-decoration:none;margin-top:8px;transition:all .15s}
.btn.pcap{background:#1f6feb;color:#fff}.btn.pcap:hover{background:#388bfd}
.btn.fuzz{background:#21262d;color:var(--fg);border:1px solid var(--border)}.btn.fuzz:hover{background:#30363d;border-color:var(--accent)}
.btn.estop{background:var(--red);color:#fff;font-size:15px;padding:12px}.btn.estop:hover{background:#b62324}
.bar-track{width:100%;height:14px;background:#21262d;border-radius:7px;overflow:hidden;margin:4px 0}
.bar-fill{height:100%;background:var(--accent);width:50%;transition:width .1s linear}
.term{background:#010409;border:1px solid var(--border);border-radius:8px;padding:12px;font-family:ui-monospace,SFMono-Regular,Menlo,monospace;font-size:12px;height:260px;overflow-y:auto;display:flex;flex-direction:column-reverse}
.term-line{margin:2px 0;line-height:1.4}
.src-wtf{color:#7ee787}.src-daphne{color:var(--purple)}.src-hestia{color:var(--accent)}.src-iris{color:#ff7b72}.src-action{color:var(--yellow)}
.tab-bar{display:flex;gap:8px;margin-bottom:8px}
.tab{padding:6px 12px;background:#21262d;border:1px solid var(--border);border-radius:6px;cursor:pointer;font-size:12px;font-weight:600}
.tab.active{background:var(--accent);color:#fff;border-color:var(--accent)}
</style></head><body>

<div class="hdr">
  <div><span class="title">whattheflip</span> <span class="badge">ESP32-C6 µT-Kernel 3.0</span> <span class="badge" id="b-safety">SAFETY: ARMED</span></div>
  <div><span class="badge" id="b-boards">3 Boards Live</span></div>
</div>

<div id="toast" class="toast"></div>

<div class="grid">
  <!-- Sensor Orientation & Accel Card -->
  <div class="card">
    <div>
      <h3>Daphne GY-511 Tilt Vector (Core 1, 400 kHz)</h3>
      <div class="row"><span>Accel X (Roll):</span><span id="v-acc-x" class="val">0 mg</span></div>
      <div class="bar-track"><div id="b-acc-x" class="bar-fill" style="width:50%"></div></div>
      <div class="row"><span>Accel Y (Pitch):</span><span id="v-acc-y" class="val">0 mg</span></div>
      <div class="bar-track"><div id="b-acc-y" class="bar-fill" style="width:50%"></div></div>
      <div class="row"><span>Accel Z (1g Gravity):</span><span id="v-acc-z" class="val">980 mg</span></div>
      <div class="bar-track"><div id="b-acc-z" class="bar-fill" style="width:98%;background:#7ee787"></div></div>
      <div class="row" style="margin-top:10px"><span>Mag Vector:</span><span id="v-mag" class="val">X:-300 Y:50 Z:60</span></div>
    </div>
  </div>

  <!-- Packet Sniffer & BER Card -->
  <div class="card">
    <div>
      <h3>Sniffer &amp; Bit Error Rate (FR-1, FR-5)</h3>
      <div class="stat" id="stat-ber">0.000%</div>
      <div class="row"><span>Hestia TX Bursts (2 Hz):</span><span id="v-htx" class="val">0</span></div>
      <div class="row"><span>Daphne Valid Frames:</span><span id="v-val" class="val">0</span></div>
      <div class="row"><span>Corrupted Frames:</span><span id="v-cor" class="val alert">0</span></div>
      <div class="row"><span>Scientific BER:</span><span id="v-ber-exp" class="val">0.0e0</span></div>
      <div class="row"><span>Wi-Fi 6 Frames (Ch 1..13):</span><span id="v-wifi" class="val">0</span></div>
      <div class="row"><span>802.15.4 Frames (Ch 15):</span><span id="v-154" class="val">0</span></div>
      <div class="row"><span>Iris 802.15.4 TX Bursts:</span><span id="v-itx" class="val">0</span></div>
      <div class="row"><span>Wireshark PCAP Size:</span><span id="v-pcap" class="val">5004 B</span></div>
    </div>
    <div><a href="/capture.pcap" download="capture.pcap" class="btn pcap">Download capture.pcap</a></div>
  </div>

  <!-- Interactive Fault Injection Controls -->
  <div class="card">
    <div>
      <h3>Hardware Fault Controls (FR-5, FR-7)</h3>
      <button class="btn fuzz" onclick="trigger('U', 'Injected 10 µs UART Bit Flip on Row 12 (Probe 0)')">⚡ Inject UART Bit Flip (10 µs)</button>
      <button class="btn fuzz" onclick="trigger('A', 'Injected 50 µs I2C ACK-Kill on Row 43 (Probe 2)')">💥 Inject I2C ACK-Kill (50 µs)</button>
      <button class="btn fuzz" onclick="trigger('S', 'Injected 50 µs I2C Clock Stretch on Row 42 (Probe 3)')">⏱️ Inject I2C Clock Stretch (50 µs)</button>
      <button class="btn fuzz" onclick="trigger('W', 'Injected Targeted 802.15.4 Jam to Iris BSSID 02:00:00:00:00:03 (FR-6)')">📡 Inject Wireless Jam to Iris (FR-6)</button>
      <button class="btn estop" onclick="trigger('E', 'EMERGENCY STOP! Probes floated in < 200 ns.')">🛑 TRIGGER HARDWARE E-STOP</button>
    </div>
  </div>
</div>

<!-- Multi-Board Live Streaming Log Terminal -->
<div class="card" style="margin-top:16px">
  <div style="display:flex;justify-content:space-between;align-items:center">
    <div class="tab-bar">
      <span class="tab active" onclick="setFilter('ALL', this)">ALL BOARDS</span>
      <span class="tab" onclick="setFilter('WTF', this)">WHATTHEFLIP</span>
      <span class="tab" onclick="setFilter('DAPHNE', this)">DAPHNE</span>
      <span class="tab" onclick="setFilter('HESTIA', this)">HESTIA</span>
      <span class="tab" onclick="setFilter('IRIS', this)">IRIS</span>
    </div>
    <span style="font-size:12px;color:#8b949e">Streaming Live @ 5 Hz</span>
  </div>
  <div class="term" id="term-box"></div>
</div>

<script>
var filter = 'ALL';
function setFilter(f, el){
  filter = f;
  document.querySelectorAll('.tab').forEach(t=>t.classList.remove('active'));
  el.classList.add('active');
  renderLogs();
}

function trigger(cmd, desc){
  fetch('/cmd?c=' + cmd, {method:'POST'}).then(()=>{
    showToast(desc);
  }).catch(console.error);
}

function showToast(msg){
  var t = document.getElementById('toast');
  t.textContent = msg;
  t.style.display = 'block';
  setTimeout(()=>{ t.style.display='none'; }, 3000);
}

var lastLogs = [];
function renderLogs(){
  var box = document.getElementById('term-box');
  box.innerHTML = '';
  for(var i = lastLogs.length - 1; i >= 0; i--){
    var l = lastLogs[i];
    if(filter !== 'ALL' && l.src !== filter) continue;
    var div = document.createElement('div');
    div.className = 'term-line';
    var srcClass = 'src-' + l.src.toLowerCase();
    div.innerHTML = '<span style="color:#8b949e">['+l.time+']</span> <b class="'+srcClass+'">['+l.src+']</b> ' + escapeHtml(l.text);
    box.appendChild(div);
  }
}

function escapeHtml(s){
  return s.replace(/&/g,"&amp;").replace(/</g,"&lt;").replace(/>/g,"&gt;");
}

function pollTelemetry(){
  fetch('/telemetry').then(r=>r.json()).then(d=>{
    // Accel
    var ax = d.accel.x, ay = d.accel.y, az = d.accel.z;
    document.getElementById('v-acc-x').textContent = ax + ' mg';
    document.getElementById('v-acc-y').textContent = ay + ' mg';
    document.getElementById('v-acc-z').textContent = az + ' mg';
    
    // Map -1000..+1000 mg to 0..100%
    document.getElementById('b-acc-x').style.width = Math.min(100, Math.max(0, (ax + 1000) / 20)) + '%';
    document.getElementById('b-acc-y').style.width = Math.min(100, Math.max(0, (ay + 1000) / 20)) + '%';
    document.getElementById('b-acc-z').style.width = Math.min(100, Math.max(0, (az + 1000) / 20)) + '%';

    document.getElementById('v-mag').textContent = 'X:' + d.mag.x + ' Y:' + d.mag.y + ' Z:' + d.mag.z;
    
    // BER & Packets
    document.getElementById('stat-ber').textContent = d.ber_percent || '0.000%';
    document.getElementById('v-ber-exp').textContent = d.ber || '0.0e0';
    document.getElementById('v-htx').textContent = d.hestia_tx || 0;
    document.getElementById('v-val').textContent = d.valid_frames || 0;
    document.getElementById('v-cor').textContent = d.corrupted_frames || 0;
    document.getElementById('v-pcap').textContent = (d.pcap_bytes || 5004) + ' B';
    document.getElementById('v-wifi').textContent = d.wifi_pkts || 0;
    document.getElementById('v-154').textContent = d.ieee154_pkts || 0;
    document.getElementById('v-itx').textContent = d.iris_tx || 0;
    
    var bSafe = document.getElementById('b-safety');
    bSafe.textContent = 'SAFETY: ' + d.safety;
    if(d.safety === 'ABORTED'){
      bSafe.className = 'badge alert';
    } else {
      bSafe.className = 'badge';
    }
  }).catch(console.error);
}

function pollLogs(){
  fetch('/logs').then(r=>r.json()).then(data=>{
    lastLogs = data;
    renderLogs();
  }).catch(console.error);
}

setInterval(pollTelemetry, 200);
setInterval(pollLogs, 400);
pollTelemetry();
pollLogs();
</script></body></html>"""

def main():
    t_wtf = threading.Thread(target=whattheflip_reader, daemon=True)
    t_daphne = threading.Thread(target=daphne_reader, daemon=True)
    t_hestia = threading.Thread(target=hestia_reader, daemon=True)
    
    t_wtf.start()
    t_daphne.start()
    t_hestia.start()
    t_iris = threading.Thread(target=iris_reader, daemon=True)
    t_iris.start()
    server = HTTPServer(("0.0.0.0", PORT), DashboardHandler)
    print(f"=== whattheflip Multi-Board Dashboard Bridge Online ===")
    print(f"Open in your browser: http://localhost:{PORT}")
    try:
        server.serve_forever()
    except KeyboardInterrupt:
        pass

if __name__ == "__main__":
    main()
