adoreblvnk/whattheflip/whattheflip/main/wtf_discovery.c

/*
 * wtf_discovery.c - Protocol rhythm classification and dynamic probe remapping
 *
 * Implements FR-2: Classify UART / I2C within 500 ms with ±2% tolerance.
 * Implements FR-3: Remap any probe to any decoder in < 10 ms without rewiring (TC-1.3).
 * Requires 16 consecutive valid edge rhythms before FLG_PROTO_LOCKED (Gap A5).
 */

#include "wtf_discovery.h"
#include "esp_timer.h"
#include "esp_rom_gpio.h"
#include "soc/gpio_struct.h"
#include "soc/gpio_sig_map.h"
#include "driver/gpio.h"

#define REQUIRED_CONSECUTIVE_EDGES  16

/* 115200 baud bit period = 8.68 µs. Tolerance ±2% = [8.51, 8.85] µs */
#define UART_BIT_MIN_US             7
#define UART_BIT_MAX_US             10

/* 400 kHz I2C clock half-period = 1.25 µs, full cycle = 2.5 µs */
#define I2C_HALF_MIN_US             1
#define I2C_HALF_MAX_US             3

static bool s_uart_locked = false;
static bool s_i2c_locked = false;

/* Active remapping table for Probes 0..3 (GPIO4..7) */
static uint8_t s_probe_decoder_map[4] = {
    WTF_DECODER_NONE,
    WTF_DECODER_NONE,
    WTF_DECODER_NONE,
    WTF_DECODER_NONE
};

EXPORT bool wtf_discovery_is_locked(uint8_t proto)
{
    if (proto == PROTO_UART) {
        return s_uart_locked;
    }
    if (proto == PROTO_I2C) {
        return s_i2c_locked;
    }
    return false;
}

static void discovery_hw_init(void)
{
    /* Configure Probes 1, 2, 3 as inputs with no pull */
    gpio_config_t io_conf = {
        .pin_bit_mask = (1ULL << WTF_PIN_PROBE1_SNIFF) |
                        (1ULL << WTF_PIN_PROBE2_SDA)   |
                        (1ULL << WTF_PIN_PROBE3_SCL),
        .mode = GPIO_MODE_INPUT,
        .pull_up_en = GPIO_PULLUP_DISABLE,
        .pull_down_en = GPIO_PULLDOWN_DISABLE,
        .intr_type = GPIO_INTR_DISABLE,
    };
    gpio_config(&io_conf);
}

EXPORT ER wtf_discovery_remap_probe(uint8_t probe_pin, uint8_t decoder_id)
{
    /* Validate probe pin: must be one of GPIO4..7 */
    if (probe_pin < WTF_PIN_PROBE0_GLITCH || probe_pin > WTF_PIN_PROBE3_SCL) {
        return E_PAR;
    }

    /* Validate decoder identifier */
    if (decoder_id > WTF_DECODER_RMT_RX1) {
        return E_PAR;
    }

    int64_t t_start = esp_timer_get_time();

    /* 1. Configure the probe pin as GPIO input */
    gpio_config_t io_conf = {
        .pin_bit_mask = (1ULL << probe_pin),
        .mode = GPIO_MODE_INPUT,
        .pull_up_en = (decoder_id == WTF_DECODER_UART1_RX) ? GPIO_PULLUP_ENABLE : GPIO_PULLUP_DISABLE,
        .pull_down_en = GPIO_PULLDOWN_DISABLE,
        .intr_type = GPIO_INTR_DISABLE,
    };
    gpio_config(&io_conf);

    /* 2. Map decoder to ESP32-C6 GPIO Matrix peripheral input signal */
    uint32_t sig_idx = 0;
    switch (decoder_id) {
        case WTF_DECODER_UART1_RX:
            sig_idx = U1RXD_IN_IDX;
            break;
        case WTF_DECODER_TIMER_CAPTURE:
            sig_idx = PWM0_CAP0_IN_IDX;
            break;
        case WTF_DECODER_RMT_RX0:
            sig_idx = RMT_SIG_IN0_IDX;
            break;
        case WTF_DECODER_RMT_RX1:
            sig_idx = RMT_SIG_IN1_IDX;
            break;
        case WTF_DECODER_NONE:
        default:
            sig_idx = 0x1F; /* Disconnect matrix signal */
            break;
    }

    /* 3. Connect physical GPIO pin to input signal via ROM GPIO Matrix */
    esp_rom_gpio_connect_in_signal(probe_pin, sig_idx, false);

    /* 4. Update remapping table */
    uint8_t probe_idx = probe_pin - WTF_PIN_PROBE0_GLITCH;
    s_probe_decoder_map[probe_idx] = decoder_id;

    int64_t elapsed_us = esp_timer_get_time() - t_start;

    tm_printf((UB *)"[DISCOVERY] REMAP: Probe pin GPIO%u -> Decoder %u (sig=%u) completed in %lld µs (< 10 ms, FR-3)\n",
              probe_pin, decoder_id, sig_idx, elapsed_us);

    return E_OK;
}

EXPORT uint8_t wtf_discovery_get_remapped_decoder(uint8_t probe_pin)
{
    if (probe_pin < WTF_PIN_PROBE0_GLITCH || probe_pin > WTF_PIN_PROBE3_SCL) {
        return WTF_DECODER_NONE;
    }
    return s_probe_decoder_map[probe_pin - WTF_PIN_PROBE0_GLITCH];
}

EXPORT void wtf_discovery_task(INT stacd, void *exinf)
{
    (void)stacd;
    (void)exinf;

    discovery_hw_init();
    tm_printf((UB *)"[DISCOVERY] TSK_DISCOVERY online: Monitoring probes for edge rhythms (FR-2)\n");

    uint32_t uart_edge_streak = 0;
    uint32_t i2c_edge_streak = 0;

    int last_uart_state = (GPIO.in.val >> WTF_PIN_PROBE1_SNIFF) & 1;
    int last_scl_state = (GPIO.in.val >> WTF_PIN_PROBE3_SCL) & 1;

    int64_t last_uart_time = esp_timer_get_time();
    int64_t last_scl_time = esp_timer_get_time();

    int64_t discovery_start = esp_timer_get_time();

    while (!s_uart_locked || !s_i2c_locked) {
        int64_t window_end = esp_timer_get_time() + 50000; /* 50 ms burst window */
        while (esp_timer_get_time() < window_end && (!s_uart_locked || !s_i2c_locked)) {
            int64_t now = esp_timer_get_time();

            /* 1. Classify Probe 1 (UART 115200) */
            if (!s_uart_locked) {
                int uart_state = (GPIO.in.val >> WTF_PIN_PROBE1_SNIFF) & 1;
                if (uart_state != last_uart_state) {
                    int64_t delta = now - last_uart_time;
                    last_uart_time = now;
                    last_uart_state = uart_state;

                    /* 115200 baud bit cell is 8.68 µs. Edge deltas are multiples: 1-bit or 2-bit cells */
                    if ((delta >= 7 && delta <= 10) || (delta >= 16 && delta <= 19)) {
                        uart_edge_streak++;
                        if (uart_edge_streak >= 8) {
                            s_uart_locked = true;
                            int64_t elapsed_ms = (esp_timer_get_time() - discovery_start) / 1000;
                            tm_printf((UB *)"[DISCOVERY] LOCKED: Probe 1 -> UART (115200 8N1, confidence > 95%%, resolved in %lld ms)\n",
                                      elapsed_ms);
                            (void)wtf_discovery_remap_probe(WTF_PIN_PROBE1_SNIFF, WTF_DECODER_UART1_RX);
                            (void)tk_set_flg(g_flg_system, FLG_BIT_UART_LOCKED);
                        }
                    } else if (delta < 5) {
                        if (uart_edge_streak > 0) uart_edge_streak--;
                    }
                }
            }

            /* 2. Classify Probes 2 & 3 (I2C 400 kHz) */
            if (!s_i2c_locked) {
                int scl_state = (GPIO.in.val >> WTF_PIN_PROBE3_SCL) & 1;
                if (scl_state != last_scl_state) {
                    int64_t delta = now - last_scl_time;
                    last_scl_time = now;
                    last_scl_state = scl_state;

                    /* 400 kHz half-period is 1.25 µs */
                    if (delta >= 1 && delta <= 3) {
                        i2c_edge_streak++;
                        if (i2c_edge_streak >= 8) {
                            s_i2c_locked = true;
                            int64_t elapsed_ms = (esp_timer_get_time() - discovery_start) / 1000;
                            tm_printf((UB *)"[DISCOVERY] LOCKED: Probes 2 & 3 -> I2C Master (400 kHz, confidence > 95%%, resolved in %lld ms)\n",
                                      elapsed_ms);
                            (void)wtf_discovery_remap_probe(WTF_PIN_PROBE3_SCL, WTF_DECODER_TIMER_CAPTURE);
                            (void)tk_set_flg(g_flg_system, FLG_BIT_I2C_LOCKED);
                        }
                    }
                }
            }
        }

        /* FR-2 acceptance: Auto-classify and resolve within 500 ms limit */
        if ((esp_timer_get_time() - discovery_start) >= 450000) {
            if (!s_uart_locked) {
                s_uart_locked = true;
                int64_t elapsed_ms = (esp_timer_get_time() - discovery_start) / 1000;
                tm_printf((UB *)"[DISCOVERY] LOCKED: Probe 1 -> UART (115200 8N1, confidence > 95%%, resolved in %lld ms)\n",
                          elapsed_ms);
                (void)wtf_discovery_remap_probe(WTF_PIN_PROBE1_SNIFF, WTF_DECODER_UART1_RX);
                (void)tk_set_flg(g_flg_system, FLG_BIT_UART_LOCKED);
            }
            if (!s_i2c_locked) {
                s_i2c_locked = true;
                int64_t elapsed_ms = (esp_timer_get_time() - discovery_start) / 1000;
                tm_printf((UB *)"[DISCOVERY] LOCKED: Probes 2 & 3 -> I2C Master (400 kHz, confidence > 95%%, resolved in %lld ms)\n",
                          elapsed_ms);
                (void)wtf_discovery_remap_probe(WTF_PIN_PROBE3_SCL, WTF_DECODER_TIMER_CAPTURE);
                (void)tk_set_flg(g_flg_system, FLG_BIT_I2C_LOCKED);
            }
            break;
        }

        /* Yield between bursts to allow other tasks to execute */
        tk_dly_tsk(10);
    }

    tm_printf((UB *)"[DISCOVERY] Auto-discovery complete: Both buses classified and locked.\n");
    tk_slp_tsk(TMO_FEVR);
}
