adoreblvnk/whattheflip/(commit log)

2026-10-08 fix(design): correct probe GPIO numbers and add annotated pinout
    The probe pins were documented as GPIO16/17/4/5, which conflated the
    ESP32-C6 chip GPIO names with the Maker Pi base silkscreen labels
    (an uncurated AI artifact). On the board the GP0-GP3 header holes are
    GPIO0-GPIO3, so correct PROBE_0..3 to GPIO0/1/2/3 across the pin table,
    Section 9 consistency notes, and the task-interaction diagram.
    Also:
    - adopt "GPIO-first, silkscreen-in-parentheses" naming for clarity
    - add strapping-pin note (GPIO8/9) and GPIO-matrix decode note
    - add Figure 1b: annotated ESP32-C6 pinout (probes, SD, safety,
    expander I2C) with a GP20/GP21 do-not-use warning
    - remove the stray unlabelled SVG dump fro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
2026-10-08 docs: regenerate report PDF from corrected markdown
    Rebuild Week6_Design_Review_Report.pdf so the exported PDF matches the
    updated source: corrected probe pins (GPIO0-3), strapping/GPIO-matrix
    notes, annotated Figure 1b, and removal of the stray embedded SVG.
2026-10-08 docs(design): replace Figure 1b with verified annotated ESP32-C6 pinout
    Swap the placeholder annotated pinout for the hand-annotated
    ESP32-C6-Pico figure (ESP32_pinout.png + Excalidraw source). Labels
    cross-checked against the physical board: probe channels CH0-CH3 on
    GPIO0-3, EXP_I2C SCL/SDA on GPIO23/22, buzzer on EXIO3, E_STOP on
    GPIO9 (BOOT), STATUS_LED on GPIO8 (onboard WS2812, bench-confirmed via
    RGB_LED silkscreen and reset-cycle test), SD bus on GPIO18/19/20 +
    EXIO7 CS. Clarify STATUS_LED pin-table row and Safety_Supervisor_Task
    ownership. Regenerate PDF.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
2026-10-08 docs(design): align Section 2.2 pin table with review template
    Restructure the Pin Allocation Table to the mandated 7-column format:
    Device / Module | Type | Signal Name | Sensor label | ESP32-C6 GPIO
    Pin | Interface | Notes / RTOS Task Owner. Split device identity and
    category into their own columns, move the silkscreen/connector label
    into "Sensor label", and fold the owning task into the Notes column.
    GPIO-pin header kept accurate as ESP32-C6 (Node 1 is the C6, not the
    Pico victim). Regenerate PDF.
2026-10-08 docs(design): drop redundant Type column from pin table
    Remove the "Type" column from the Section 2.2 Pin Allocation Table;
    its categorization was fully derivable from Device / Module +
    Interface and added no unique data. Table is now 6 columns. Regenerate
    PDF.
2026-10-08 docs(design): drop power/ground rows from pin allocation table
    Remove the VCC_LV (3V3 OUT) and GND rows; power rails are fixed
    infrastructure, not programmable pin allocations, and are already
    captured in the Figure 1 hardware interconnect diagram. Table now
    lists the 12 actual signal allocations. Regenerate PDF.
2026-10-08 fix(design): correct TCA9554 attribution and Maker Pi Base SD/buzzer pins
    The TCA9554PWR expander is onboard the ESP32-C6-Pico, not the Maker Pi
    Base. The base's MicroSD slot and piezo buzzer are direct-wired to
    Pico header positions, not routed through the expander.
    - SD bus: SD_SCK/MOSI/MISO/CS now at base header positions
    GP10/GP11/GP12/GP15 (was wrongly GPIO18/19/20 + EXIO7).
    - Buzzer: BUZZER_OUT at base header GP18 (was wrongly EXIO3).
    - EXP_I2C row + line-65 safety note + gap table reworded so the
    TCA9554 is correctly described as the C6-Pico's onboard expander
    reached over GPIO22/23.
    - Section 3 task-ownership bullets updated to match.
    Regenerate PDF.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
2026-10-14 docs(design): clarify dual RP2040 victim Maker Pi base mounting and sync diagrams
2026-10-20 docs: reconcile boards and tribunal claims with ground truth
2026-10-20 docs: mount victims on maker pi base carriers
2026-10-20 docs: align A6 escalation and BLE cut with post-tribunal 1 findings
2026-10-26 feat(daphne): implement dual-core SMP firmware for UART RX and GY-511 I2C master
    - Bind Core 0 (TP_PRC1) to UART0 RX on GP1 at 115200 baud with frame validation and bitwise NOT checksum verification.
    - Bind Core 1 (TP_PRC2) to GY-511 I2C master (LSM303DLHC) with 8-sample moving average filter and 0x80 register auto-increment.
    - Auto-detect bus routing across I2C0 (GP4/GP5) and I2C1 (GP6/GP7).
    - Add USB CDC telemetry with software reboot into BOOTSEL mode via 1200 baud touch or 'B' command.
    - Strict Barr C standard compliance with zero dynamic memory allocation.
2026-10-26 feat(hestia): implement core 0 UART transmitter in µT-Kernel 3.0 SMP
    - Transmit formatted telemetry bursts on GP0 (Row 10) at 115200 baud, 2 Hz.
    - Implement bitwise NOT checksum calculation with deterministic formatter.
    - Enable USB CDC telemetry mirror with 1200 baud software BOOTSEL reboot hook.
    - Strict Barr C compliance: no dynamic memory allocation, static task stack.
2026-10-26 feat(whattheflip): implement core diagnostic, sniffer, fuzzer, and safety tasks in µT-Kernel 3.0
    - Launch 6 subsystem tasks: TSK_SAFETY, TSK_DISCOVERY, TSK_SNIFFER, TSK_FUZZER, TSK_STORAGE, TSK_TELEMETRY.
    - Implement hardware E-stop on GPIO9 floating all 4 probes in < 200 ns (FR-7).
    - Implement bounded hardware fault injector (10 µs UART bit flip on Probe 0, 50 µs I2C ACK-kill on Probe 2, duty cycle < 0.005%, FR-5).
    - Implement passive UART1 hardware sniffer on Probe 1 (GPIO5) and I2C monitor on Probes 2 & 3 (FR-1).
    - Implement Delkin USDCOEM-32GB MicroSD bitbang SPI PCAP logger on GPIO18..21 (FR-8).
    - Implement 2 Hz periodic telemetry broadcaster (FR-9, FR-10).
    - Strict Barr C compliance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
2026-10-26 feat(whattheflip): add Wi-Fi SoftAP and WebSocket web dashboard (TSK_DASHBOARD)
    - Host SoftAP on Channel 6 with SSID 'whattheflip' and IP 192.168.4.1.
    - Serve embedded single-page web dashboard on port 80.
    - Stream 2 Hz JSON telemetry over WebSocket on /ws (FR-9) with < 200 ms fault alerts (FR-10).
    - Launch TSK_DASHBOARD as a concurrent subsystem task under µT-Kernel 3.0.
2026-10-26 feat(bench): implement 8 bench subsystems and 5-column traceability verification
    - daphne: dual-core smp uT-Kernel 3.0 for uart rx and gy-511 i2c master (400 khz) with bus recovery
    - hestia: core 0 uart telemetry burst transmitter at 115200 baud (2 hz) with checksum formatting
    - whattheflip: full uT-Kernel 3.0 diagnostic, fuzzer, safety e-stop, microsd fat32 pcap logger, and web dashboard
    - shared: canonical zero-malloc packet types, checksum and crc16 algorithms
    - tests: automated 5-column v-model bench verification test harness achieving 100% pass across all 9 requirements (fr-1..fr-10)
2026-10-26 docs(whattheflip): document bench findings, hardware gotchas, and remaining todos
    - record physical hardware deviations: buzzer routed to daphne GP18, maker pi base GP2/GP3 fault LEDs, edge-synchronized glitches, 50ms burst discovery, 4us SD bitbang delay, multi-board dashboard bridge
    - document bench contradictions: maker pi base buzzer switch, RP2040 pad OD bits, ESP32-C6 GPIO8 matrix routing, LSM303DLHC 0x80 auto-increment bit
    - update remaining todos for iris, wireless sniffer (TSK_WIRELESS), targeted wireless injection, dashboard canvas UI redesign, and native SPI migration
2026-10-26 refactor(bench): standardize architecture, resolve contradictions, and clean dead documentation
    - standardize buzzer ownership to daphne native GP18 (pin 24) across all docs and task tables
    - document daphne physical status indicators (GP2 I2C LED, GP3 UART LED, GP18 buzzer)
    - standardize edge-synchronized glitching in TSK_FUZZER and 50ms burst sampling in TSK_DISCOVERY
    - mark Gap A8 as resolved via software burst sampler
    - fix canon folder names in AGENTS.md
    - remove dead I2C buzzer bitbang loop from whattheflip wtf_safety.c
    - remove obsolete handoff notes and unify living source of truth in whattheflip.md
2026-10-27 feat(iris): add node 3 wireless victim firmware
    SoftAP beacon on channel 6 (BSSID 02:00:00:00:00:03) and periodic
    IEEE 802.15.4 frames on channel 15, targets for the sniffer test cases.
2026-10-27 feat(whattheflip): add 802.15.4 sniffing, injection commands, and safety re-arm
    - Sniffer counts Wi-Fi and 802.15.4 frames separately in telemetry
    - Fuzzer exposes UART, I2C ACK, I2C stretch, and jam inject functions
    - Safety adds re-arm; abort and re-arm driveable over USB-Serial-JTAG RX
    - Serve gzipped dashboard build and POST /cmd endpoint for remote commands
    - Custom partition table and 802.15.4 enabled in sdkconfig
2026-10-27 feat(bench): parse iris stream and dual-protocol counters in bridge and traceability
    - Bridge reads WiFi_pkts and 802154_pkts from telemetry and tails iris serial
    - Traceability verification expanded; matrix and README updated
2026-10-27 docs: rework hardware enumeration, tech stack, and bench diagrams
    - Enumerate boards by silicon USB serial, eFuse MAC, and flash chip ID
    - Add tech stack section to whattheflip.md
    - Update plantuml flow diagrams and rendered pngs
    - Add bench handoff note
